takaki-maeda-99/GenericControlBoard/kicad/GenericControlBoard/GenericControlBoard.step

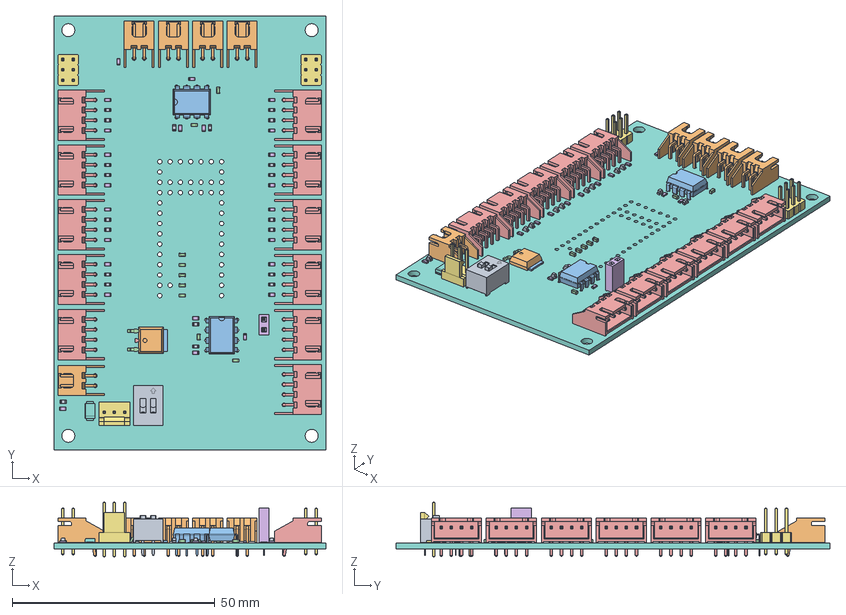
[picture p1: CAD file, 2025-08-18]
kicad/GenericControlBoard/GenericControlBoard.step
67.0 x 107.0 x 13.5 mm
LED_0603_1608Metric x 21
JST_XH_S2B-XH-A_1x02_P2.50mm_Horizontal x 5
DIP-8_W7.62mm x 2
C_0603_1608Metric x 9
JST_XH_S4B-XH-A_1x04_P2.50mm_Horizontal x 11
R_0603_1608Metric x 24
PinHeader_2x03_P2.54mm_Vertical x 2
D_SOD-128
SW_DIP_SPSTx02_Slide_9.78x7.26mm_W7.62mm_P2.54mm
cirkit 1.34.1
PinSocket_1x02_P2.54mm_Vertical
FanPinHeader_1x03_P2.54mm_Vertical
cirkit_PCB
