takaki-maeda-99/GenericControlBoard/kicad/GenericControlBoard/GenericControlBoard.kicad_pcb

## KiCad design kicad/GenericControlBoard/GenericControlBoard.kicad_pcb (2025-08-18)

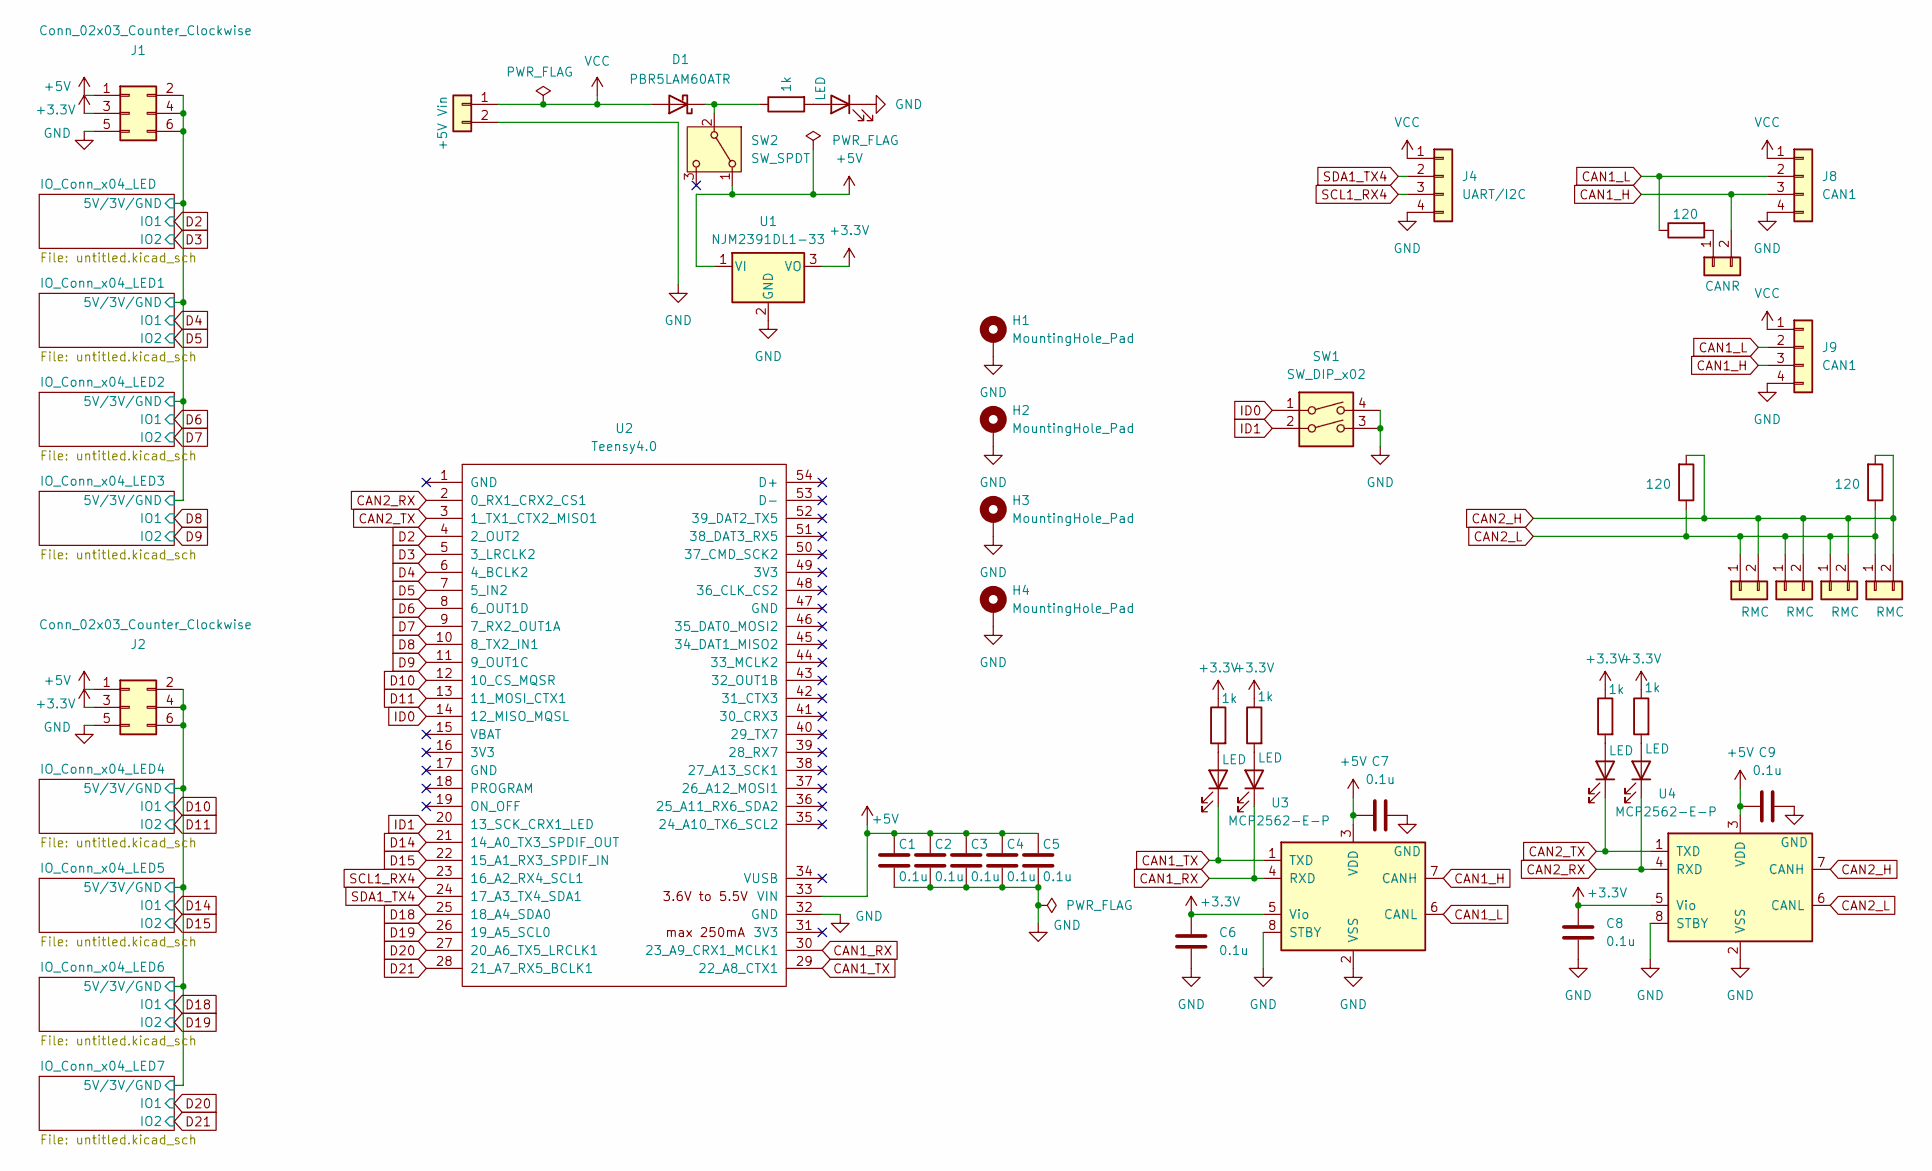
[picture p2: schematic GenericControlBoard.kicad_sch]

Parts:
C1, C2, C3, C4, C5, C6, C7, C8, C9: 0.1u; C_0603_1608Metric
D1: PBR5LAM60ATR; D_SOD-128
D2, D3, D22, D23, D24: LED; LED_0603_1608Metric
H1, H2, H3, H4: MountingHole_Pad; MountingHole_3.2mm_M3_DIN965_Pad
J1, J2: Conn_02x03_Counter_Clockwise; PinHeader_2x03_P2.54mm_Vertical
J3: +5V Vin; JST_XH_S2B-XH-A_1x02_P2.50mm_Horizontal
J4: UART/I2C; JST_XH_S4B-XH-A_1x04_P2.50mm_Horizontal
J5: CANR; PinSocket_1x02_P2.54mm_Vertical
J6, J7, J10, J11: RMC; JST_XH_S2B-XH-A_1x02_P2.50mm_Horizontal
J8, J9: CAN1; JST_XH_S4B-XH-A_1x04_P2.50mm_Horizontal
R1, R2, R24, R25, R26: 1k; R_0603_1608Metric
R4, R5, R7: 120; R_0603_1608Metric
SW1: SW_DIP_x02; SW_DIP_SPSTx02_Slide_9.78x7.26mm_W7.62mm_P2.54mm
SW2: SW_SPDT; FanPinHeader_1x03_P2.54mm_Vertical
U1: NJM2391DL1-33; TO-252-2
U2: Teensy4.0; Teensy40
U3, U4: MCP2562-E-P; DIP-8_W7.62mm

Connections:
+3.3V: C6.2, C8.2, J1.3, J2.3, R1.1, R2.1, R25.1, R26.1, U1.3 (VO), U3.5 (Vio), U4.5 (Vio); also elsewhere on the board
+5V: C1.1, C2.1, C3.1, C4.1, C5.1, C7.2, C9.2, J1.1, J2.1, SW2.1 (A), U1.1 (VI), U2.33 (VIN), U3.3 (VDD), U4.3 (VDD)
/IO_Conn_x04_LED4/5V/3V/GND: J2.2, J2.4, J2.6; also elsewhere on the board
/IO_Conn_x04_LED/5V/3V/GND: J1.2, J1.4, J1.6; also elsewhere on the board
CAN1_H: J5.2, J8.3, J9.3, U3.7 (CANH)
CAN1_L: J8.2, J9.2, R4.1, U3.6 (CANL)
CAN1_RX: D24.1 (K), U2.30 (23_A9_CRX1_MCLK1), U3.4 (RXD)
CAN1_TX: D23.1 (K), U2.29 (22_A8_CTX1), U3.1 (TXD)
CAN2_H: J6.2, J7.2, J10.2, J11.2, R5.2, R7.2, U4.7 (CANH)
CAN2_L: J6.1, J7.1, J10.1, J11.1, R5.1, R7.1, U4.6 (CANL)
CAN2_RX: D3.1 (K), U2.2 (0_RX1_CRX2_CS1), U4.4 (RXD)
CAN2_TX: D2.1 (K), U2.3 (1_TX1_CTX2_MISO1), U4.1 (TXD)
D2: U2.4 (2_OUT2); also elsewhere on the board
D3: U2.5 (3_LRCLK2); also elsewhere on the board
D4: U2.6 (4_BCLK2); also elsewhere on the board
D5: U2.7 (5_IN2); also elsewhere on the board
D6: U2.8 (6_OUT1D); also elsewhere on the board
D7: U2.9 (7_RX2_OUT1A); also elsewhere on the board
D8: U2.10 (8_TX2_IN1); also elsewhere on the board
D9: U2.11 (9_OUT1C); also elsewhere on the board
D10: U2.12 (10_CS_MQSR); also elsewhere on the board
D11: U2.13 (11_MOSI_CTX1); also elsewhere on the board
D14: U2.21 (14_A0_TX3_SPDIF_OUT); also elsewhere on the board
D15: U2.22 (15_A1_RX3_SPDIF_IN); also elsewhere on the board
D18: U2.25 (18_A4_SDA0); also elsewhere on the board
D19: U2.26 (19_A5_SCL0); also elsewhere on the board
D20: U2.27 (20_A6_TX5_LRCLK1); also elsewhere on the board
D21: U2.28 (21_A7_RX5_BCLK1); also elsewhere on the board
GND: C1.2, C2.2, C3.2, C4.2, C5.2, C6.1, C7.1, C8.1, C9.1, D22.1 (K), H1.1, H2.1, H3.1, H4.1, J1.5, J2.5, J3.2, J4.4, J8.4, J9.4, SW1.3, SW1.4, U1.2 (GND), U2.32 (GND), U3.2 (VSS), U3.8 (STBY), U4.2 (VSS), U4.8 (STBY); also elsewhere on the board
ID0: SW1.1, U2.14 (12_MISO_MQSL)
ID1: SW1.2, U2.20 (13_SCK_CRX1_LED)
unnamed: D1.1 (K), R24.1, SW2.2 (B)
unnamed: D2.2 (A), R1.2
unnamed: D3.2 (A), R2.2
unnamed: D22.2 (A), R24.2
unnamed: D23.2 (A), R25.2
unnamed: D24.2 (A), R26.2
unnamed: J5.1, R4.2
SCL1_RX4: J4.3, U2.23 (16_A2_RX4_SCL1)
SDA1_TX4: J4.2, U2.24 (17_A3_TX4_SDA1)
VCC: D1.2 (A), J3.1, J4.1, J8.1, J9.1

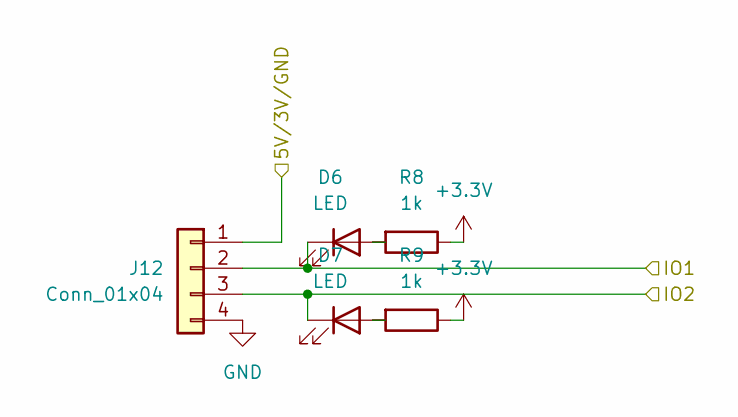
[picture p3: schematic untitled.kicad_sch]

Parts:
D6, D7: LED; LED_0603_1608Metric
J12: Conn_01x04; JST_XH_S4B-XH-A_1x04_P2.50mm_Horizontal
R8, R9: 1k; R_0603_1608Metric

Connections:
+3.3V: R8.1, R9.1; also elsewhere on the board
/IO_Conn_x04_LED/5V/3V/GND: J12.1; also elsewhere on the board
D2: D6.1 (K), J12.2; also elsewhere on the board
D3: D7.1 (K), J12.3; also elsewhere on the board
GND: J12.4; also elsewhere on the board
unnamed: D6.2 (A), R8.2
unnamed: D7.2 (A), R9.2

Parts of its further copies:
D8, D9, D10, D11, D12, D13, D14, D15, D16, D17, D18, D19, D20, D21: LED; LED_0603_1608Metric
J13, J14, J15, J16, J17, J18, J19: Conn_01x04; JST_XH_S4B-XH-A_1x04_P2.50mm_Horizontal
R10, R11, R12, R13, R14, R15, R16, R17, R18, R19, R20, R21, R22, R23: 1k; R_0603_1608Metric

Connections of its further copies:
+3.3V: R10.1, R11.1, R12.1, R13.1, R14.1, R15.1, R16.1, R17.1, R18.1, R19.1, R20.1, R21.1, R22.1, R23.1; also elsewhere on the board
/IO_Conn_x04_LED4/5V/3V/GND: J16.1, J17.1, J18.1, J19.1; also elsewhere on the board
/IO_Conn_x04_LED/5V/3V/GND: J13.1, J14.1, J15.1; also elsewhere on the board
D4: D8.1 (K), J13.2; also elsewhere on the board
D5: D9.1 (K), J13.3; also elsewhere on the board
D6: D10.1 (K), J14.2; also elsewhere on the board
D7: D11.1 (K), J14.3; also elsewhere on the board
D8: D12.1 (K), J15.2; also elsewhere on the board
D9: D13.1 (K), J15.3; also elsewhere on the board
D10: D14.1 (K), J16.2; also elsewhere on the board
D11: D15.1 (K), J16.3; also elsewhere on the board
D14: D16.1 (K), J17.2; also elsewhere on the board
D15: D17.1 (K), J17.3; also elsewhere on the board
D18: D18.1 (K), J18.2; also elsewhere on the board
D19: D19.1 (K), J18.3; also elsewhere on the board
D20: D20.1 (K), J19.2; also elsewhere on the board
D21: D21.1 (K), J19.3; also elsewhere on the board
GND: J13.4, J14.4, J15.4, J16.4, J17.4, J18.4, J19.4; also elsewhere on the board
unnamed: D8.2 (A), R10.2
unnamed: D9.2 (A), R11.2
unnamed: D10.2 (A), R12.2
unnamed: D11.2 (A), R13.2
unnamed: D12.2 (A), R14.2
unnamed: D13.2 (A), R15.2
unnamed: D14.2 (A), R16.2
unnamed: D15.2 (A), R17.2
unnamed: D16.2 (A), R18.2
unnamed: D17.2 (A), R19.2
unnamed: D18.2 (A), R20.2
unnamed: D19.2 (A), R21.2
unnamed: D20.2 (A), R22.2
unnamed: D21.2 (A), R23.2

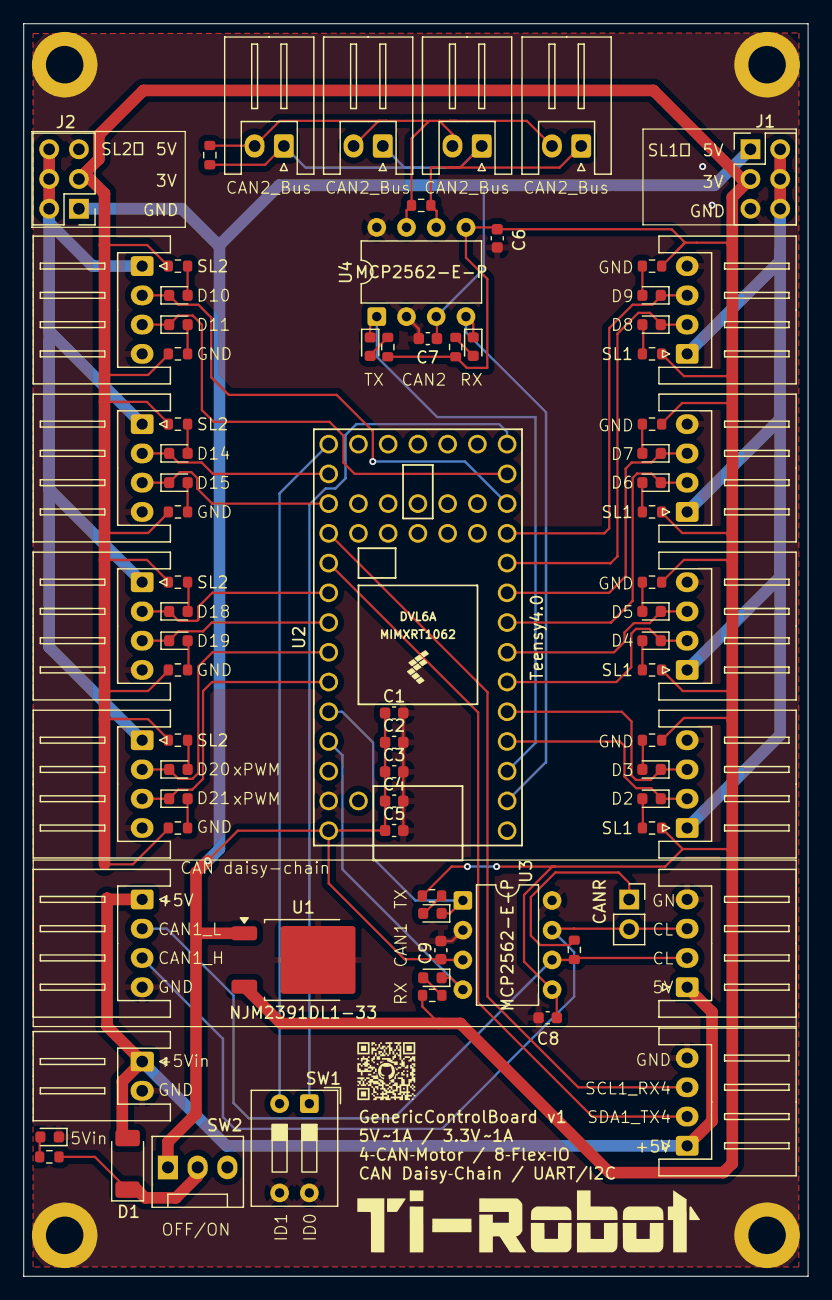
[picture p4: board GenericControlBoard.kicad_pcb from above]

Board: 2 copper layers, 67.0 x 107.0 mm, 84 parts (0 on the bottom side), 57 nets.
