takaki-maeda-99/GenericControlBoard/(commit log)

2025-08-21 can プロトコル+モーター制御
2025-08-23 プロトコル
